Arre-Jay/BlueWavePCB/BOM/Blue_Pedal_BOM.xlsx

Comment | Designator | Footprint | JLCPCB Part # | Description
STM32WB55CGU6 | U1 | UFQFPN-48(7x7) | C404023 | RF Microcontrollers - MCU Ultra-low-power
MIC5205-3.3YM5 | U2 | SOT-23-5 | C37970 | LDO 3V3 Voltage Regulators 150mA 1% Low
LIS2DH12TR | U3 | LGA-12(2x2) | C110926 | Accelerometers MEMS digital output motion sensor
USBLC6-2SC6 | U4 | SOT-23-6 | C7519 | ESD Suppressors / TVS Diodes ESD Protection Low Cap
MHT192CRCT | D1,D2,D3 | 0603 | C389517 | 5mA Colorless transparent lens Red
USB Connector
DLF162500LT-5028A1 | FLT1 | SMD-4P,0.8x1.6mm | C531364 | Low pass 0.33dB SMD-4P,0.8x1.6mm RF Filters
2450AT43B100E | AE1 | - | C2917721 | 1.3dBi Chip Antenna 2.4GHz 2W
NX2012SA-32.768KHZ-EXS00A-MU00644 | X2 | 2012-2P | C2828558 | Crystal 32.768kHz
NX2016SA-32M-EXS00A-CS06465 | X1 | 2016-4P | C1986260 | Crystal 32MHz
7914G-1-000E | SW1, SW2 | - | C840653 | Round Button 100mA
LQG15HS10NJ02D | L1 | 0402 | C77103 | 500mA 10nH ±5% 260mΩ 0402 Inductors (SMD) ROHS
LQM21FN100M70L | L2 | 0805 | C98030 | FIXED IND 10UH 100MA 780MOHM SMD
LQG15HS2N7S02D | L3, L5 | 0402 | C77108 | 800mA 2.7nH 120mΩ 0402 Inductors (SMD)
LQG15HS1N8S02D | L4 | 0402 | C77107 | 1.8nH 0402 Inductors (SMD) ROHS
RC0402FR-075K11L | R1,R2,R3,R4,R5 | 0402 | C274895 | 62.5mW Thick Film Resistors 50V ±100ppm/℃ ±1% 5.11kΩ 0402 Chip Resisto
RC0402FR-131KL | R6,R7,R8,R11,R12,R14 | 0402 | C4247997 | 62.5mW Thick Film Resistors ±100ppm/℃ ±1% 1kΩ 0402 Chip Resistor
RC0402FR-0710KL | R9,R10,R13 | 0402 | C60490 | 62.5mW Thick Film Resistors 50V ±100ppm/℃ ±1% 10kΩ 0402 Chip Resistor
C1608X5R1V475KT000E | C1,C9,C13,C14,C17,C24 | 0603 | C329940 | 35V 4.7uF X5R ±10% 0603 MLCC
C1005X7R1E104KT000F | C2,C3,C4,C5,C7,C8,C10,C18,C21,C22,C23,C25,C26,C27 | 0402 | C189396 | 25V 100nF X7R ±10% 0402 Multilayer Ceramic Capacitors MLCC
CC0402KRX7R9BB101 | C6 | 0402 | C281751 | 50V 100pF X7R ±10% 0402 MLCC
CC0402JRNPO9BN150 | C15, C16 | 0402 | C106997 | 50V 15pF NP0 ±5% 0402 Multilayer Ceramic Capacitors MLCC
GJM1555C1HR80BB01D | C19 | 0402 | C76915 | 50V 0.8pF 0402 Multilayer Ceramic Capacitors MLCC
CQ0402ARNPO9BNR30 | C20 | 0402 | C1870422 | 50V 0.3pF 0402 Multilayer Ceramic Capacitors MLCC
