Arre-Jay/BlueWavePCB/Manufacturing Files/Assembly/Assembly Drawing - Bluetooth board.pdf

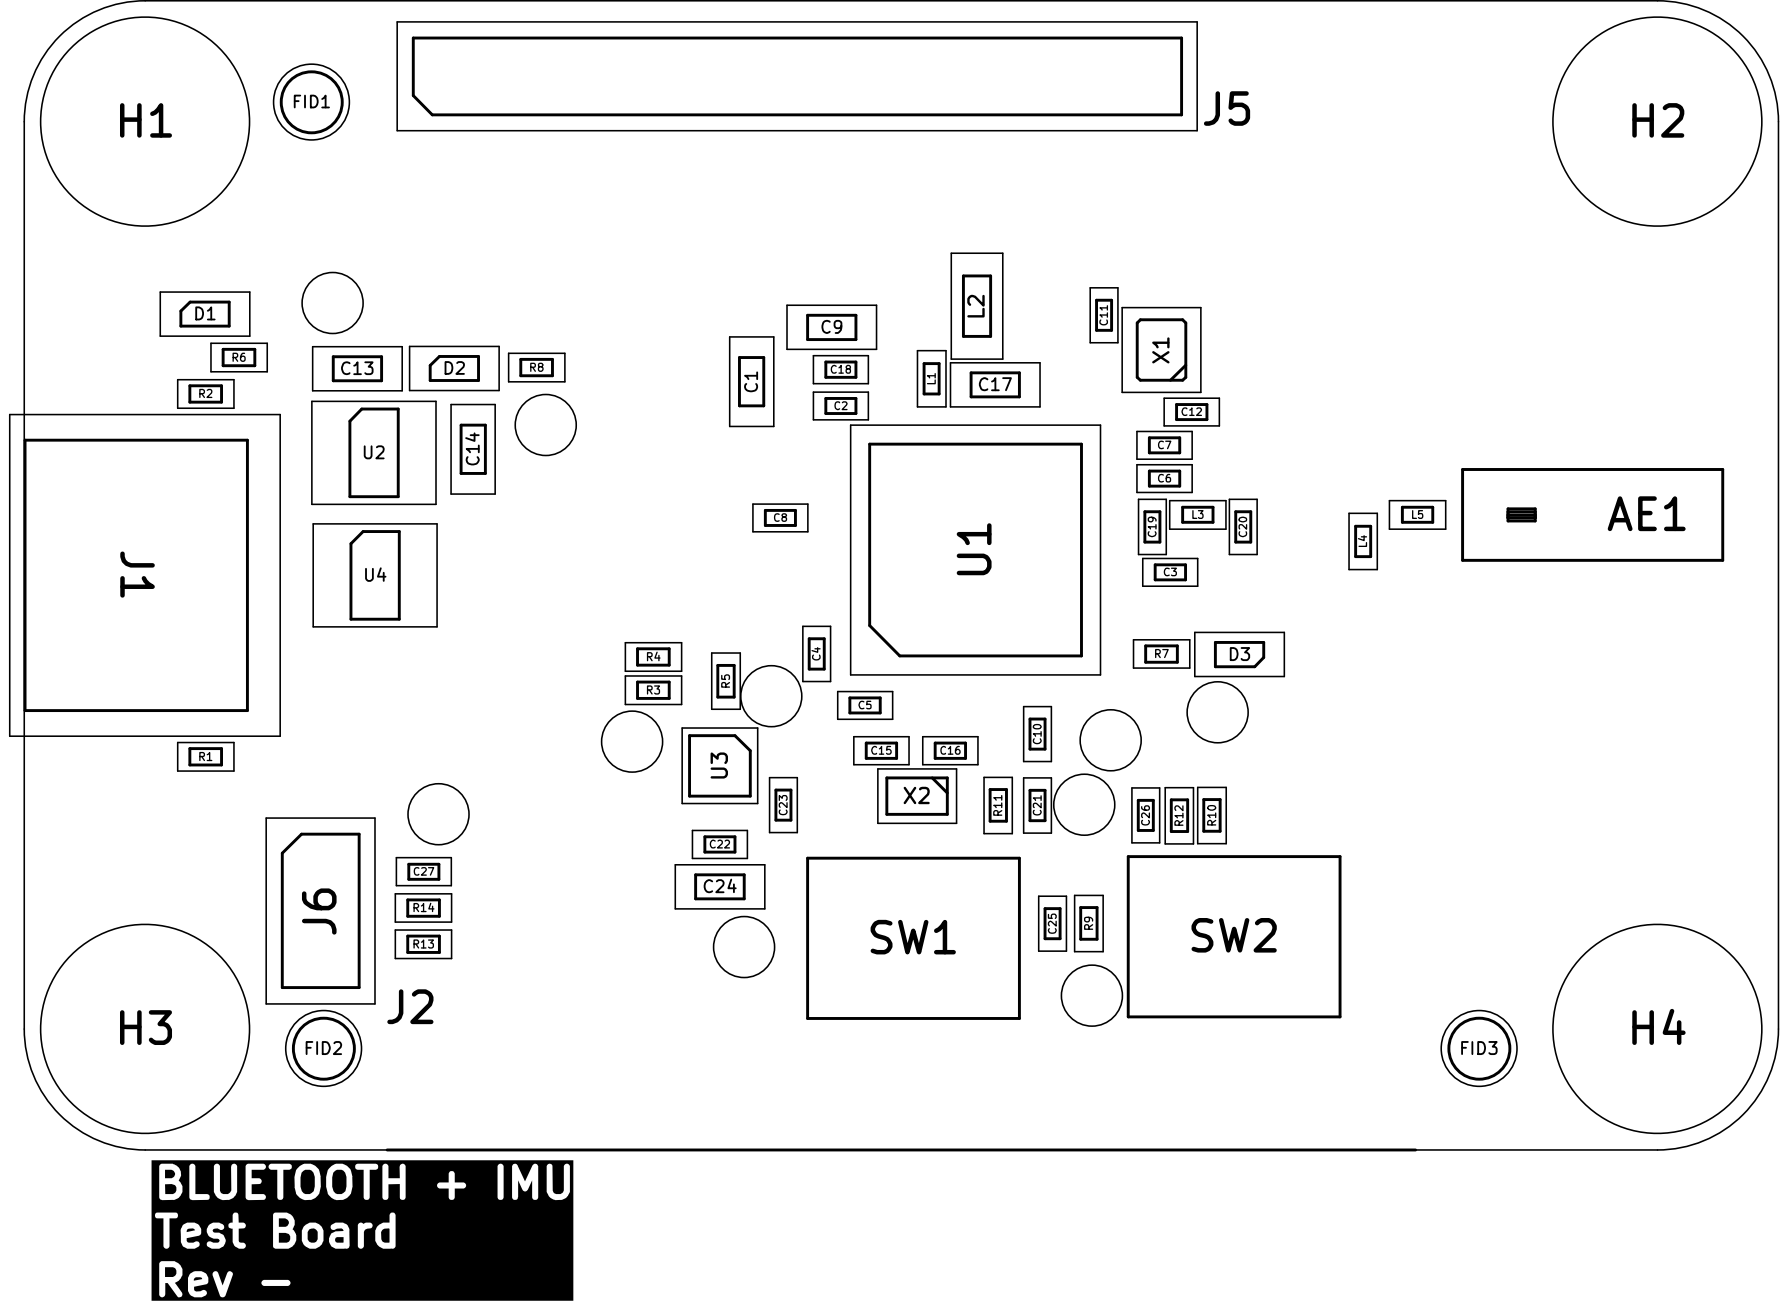
[picture p1: page 1]
