Arre-Jay/BlueWavePCB/Blue_Pedal.kicad_pcb

## KiCad design Blue_Pedal.kicad_pcb (2024-07-24)

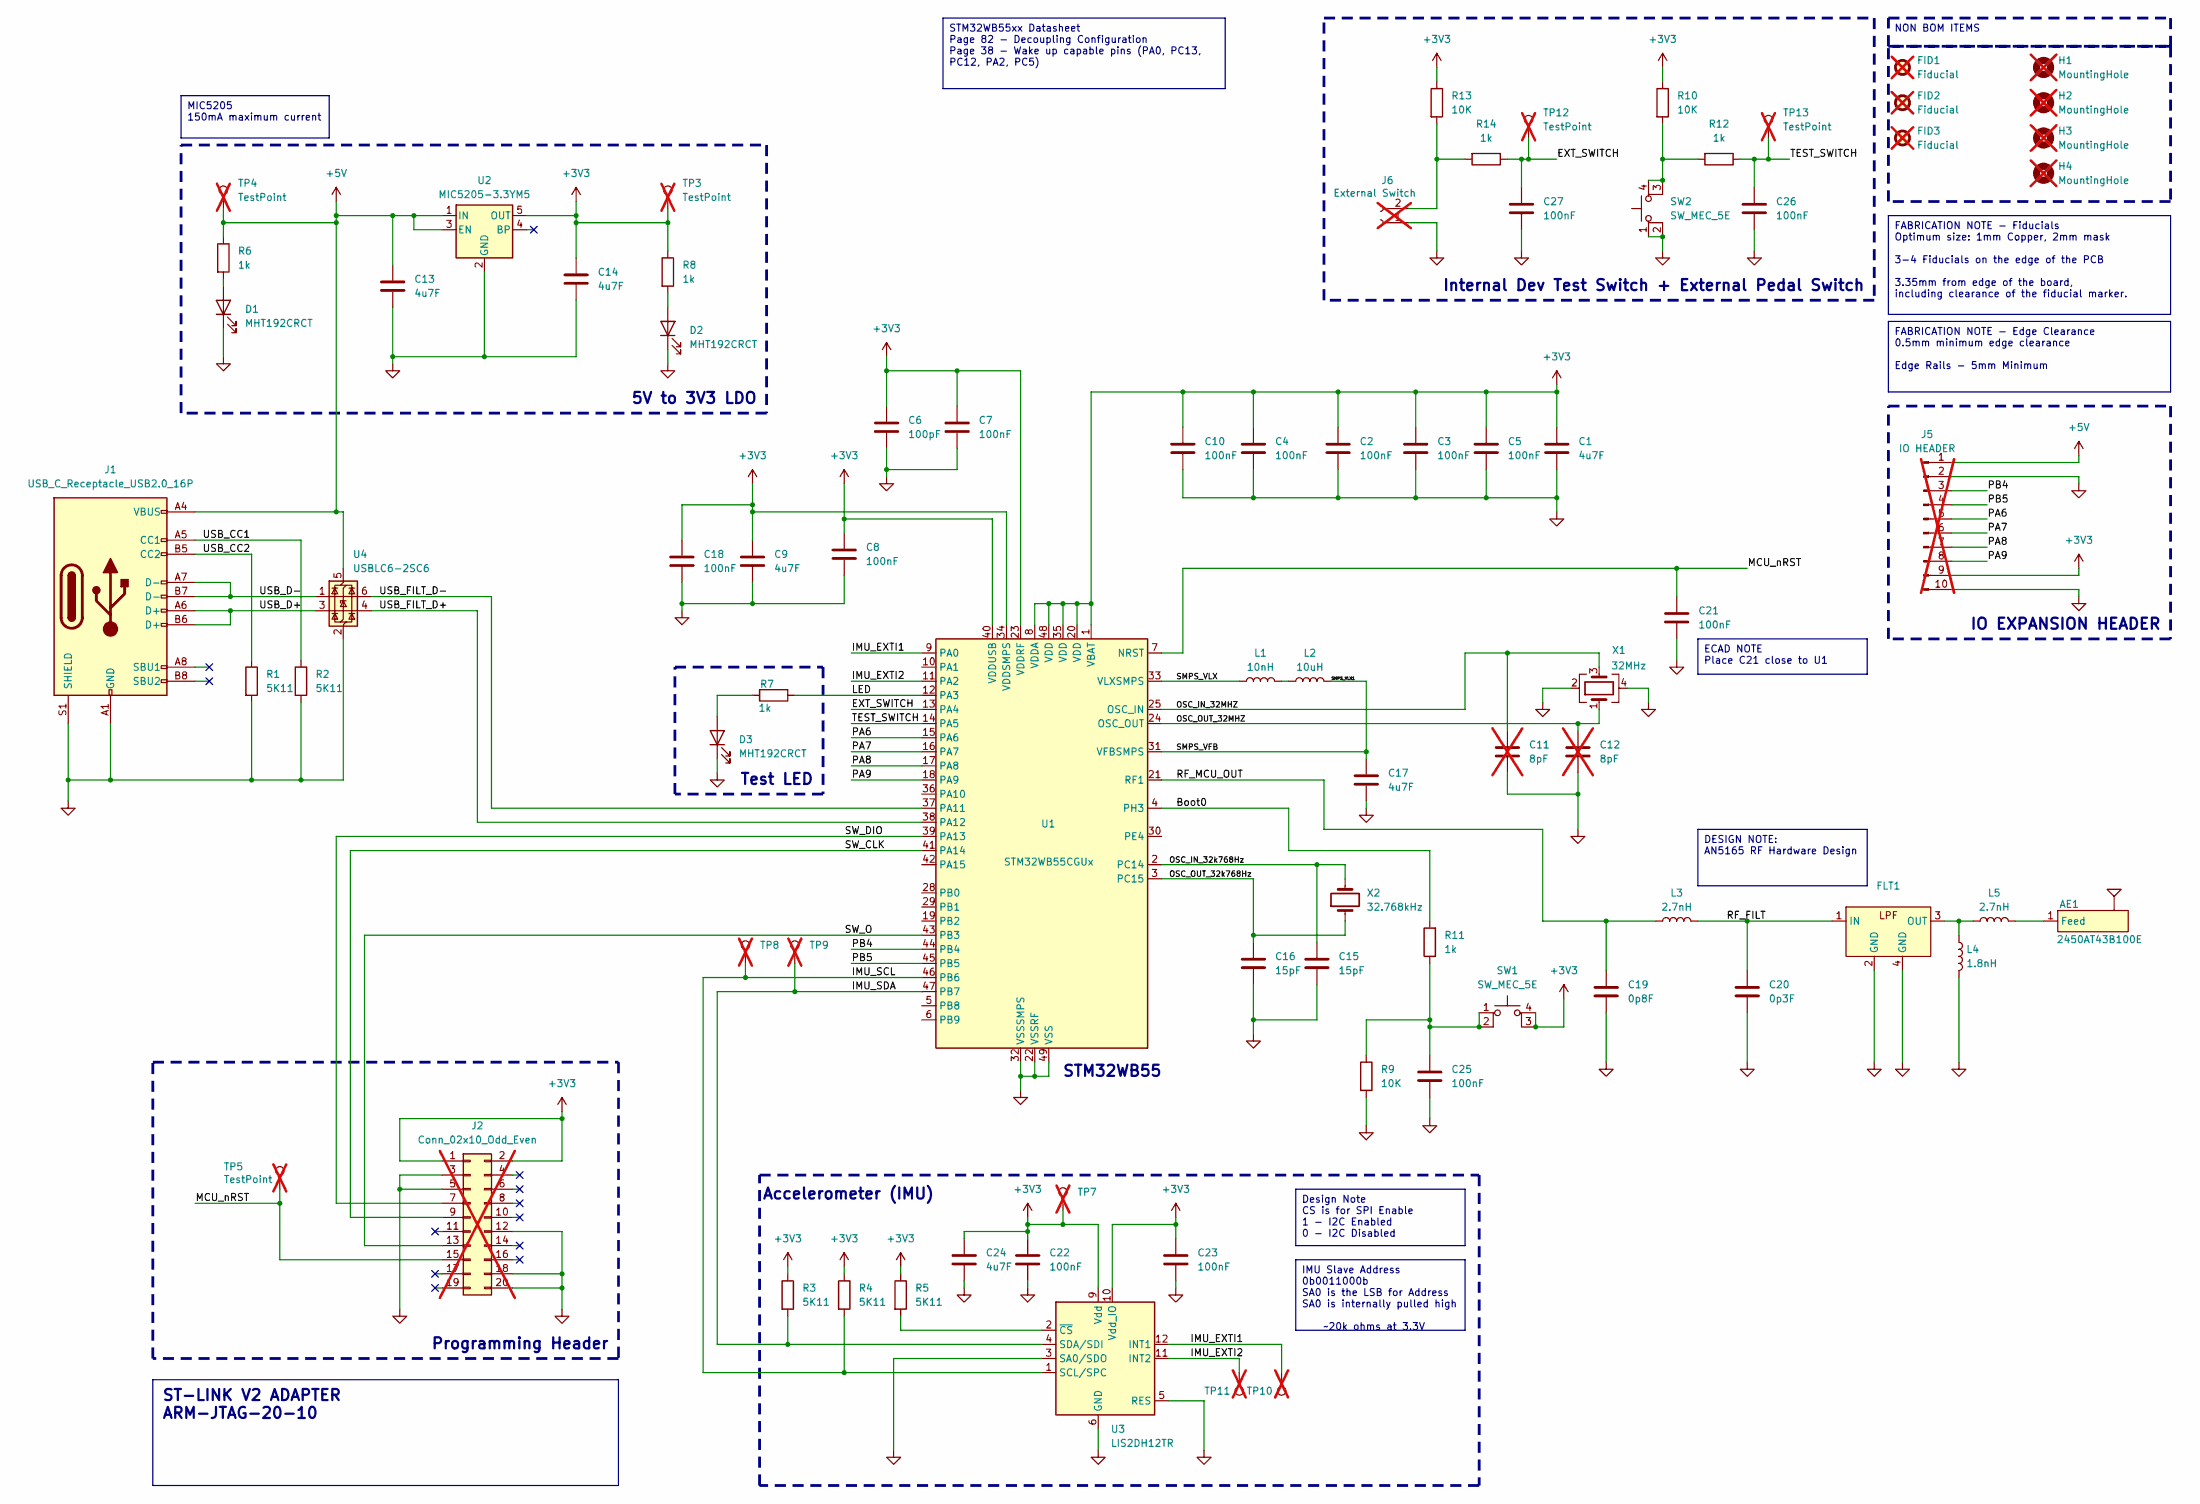
[picture p2: schematic Blue_Pedal.kicad_sch, Blue Pedal]

Parts:
AE1: 2450AT43B100E
C1, C9, C13, C14, C17, C24: 4u7F; C_0603_1608Metric; Manufacturer Part Number C1608X5R1V475KT000E; JLCPCB Part # C329940
C2, C3, C4, C5, C7, C8, C10, C18, C21, C22, C23, C25, C26, C27: 100nF; C_0402_1005Metric; Manufacturer Part Number C1005X7R1E104KT000F; JLCPCB Part # C189396
C6: 100pF; C_0402_1005Metric; Manufacturer Part Number CC0402KRX7R9BB101; JLCPCB Part # C281751
C11, C12: 8pF; C_0402_1005Metric; Manufacturer Part Number CGA2B2C0G1H080DT0Y0F; JLCPCB Part # C342939; not fitted
C15, C16: 15pF; C_0402_1005Metric; Manufacturer Part Number CC0402JRNPO9BN150; JLCPCB Part # C106997
C19: 0p8F; C_0402_1005Metric; Manufacturer Part Number GRM1555C1HR80BA01D; JLCPCB Part # C76988
C20: 0p3F; C_0402_1005Metric; Manufacturer Part Number GRM1555C1HR30BA01D; JLCPCB Part # C88939
D1, D2, D3: MHT192CRCT; LED_0603_1608Metric; Manufacturer Part Number MHT192CRCT; JLCPCB Part # C389517
FID1, FID2, FID3: Fiducial; Fiducial_1mm_Mask2mm; not fitted
FLT1: DLF162500LT-5028A1; Manufacturer Part Number DLF162500LT-5028A1; JLCPCB Part # C531364
H1, H2, H3, H4: MountingHole; MountingHole_3.2mm_M3; not fitted
J1: USB_C_Receptacle_USB2.0_16P; USB_C_Receptacle_GCT_USB4105-xx-A_16P_TopMnt_Horizontal; Manufacturer Part Number GT-USB-7047C; JLCPCB Part # C963218
J2: Conn_02x10_Odd_Even; EDGE_HEADER_20_WAY; not fitted
J5: IO HEADER; PinHeader_1x10_P2.54mm_Vertical; not fitted
J6: External Switch; PinHeader_1x02_P2.54mm_Vertical; not fitted
L1: 10nH; L_0402_1005Metric; Manufacturer Part Number LQG15WZ10NJ02D; JLCPCB Part # C3911026
L2: 10uH; L_0805_2012Metric; Manufacturer Part Number LQM21FN100M70L; JLCPCB Part # C98030
L3: 2.7nH; L_0402_1005Metric; Manufacturer Part Number LQG15HS2N7S02D; JLCPCB Part # C77108
L4: 1.8nH; L_0402_1005Metric
L5: 2.7nH; L_0402_1005Metric
R1, R2, R3, R4, R5: 5K11; R_0402_1005Metric; Manufacturer Part Number RC0402FR-075K11L; JLCPCB Part # C274895
R6, R7, R8, R11, R12, R14: 1k; R_0402_1005Metric; Manufacturer Part Number RC0402FR-131KL; JLCPCB Part # C4247997
R9, R10, R13: 10K; R_0402_1005Metric; Manufacturer Part Number RC0402FR-0710KL; JLCPCB Part # C60490
SW1, SW2: SW_MEC_5E; SMG-H9; Manufacturer Part Number SMG-H9; JLCPCB Part # C7435491
TP3, TP4, TP5, TP7, TP8, TP9, TP10, TP11, TP12, TP13: TestPoint; TestPoint_Pad_D1.0mm; Manufacturer Part Number NA; JLCPCB Part # NA; not fitted
U1: STM32WB55CGUx; QFN-48-1EP_7x7mm_P0.5mm_EP5.6x5.6mm; Manufacturer Part Number STM32WB55CGU6; JLCPCB Part # C404023
U2: MIC5205-3.3YM5; SOT-23-5; Manufacturer Part Number MIC5205-3.3YM5; JLCPCB Part # C37970
U3: LIS2DH12TR; LGA-12_2x2mm_P0.5mm; Manufacturer Part Number LIS2DH12TR; JLCPCB Part # C110926
U4: USBLC6-2SC6; SOT-23-6; Manufacturer Part Number USBLC6-2SC6; JLCPCB Part # C7519
X1: 32MHz; Crystal_SMD_2016-4Pin_2.0x1.6mm; Manufacturer Part Number NX2016SA-32M-EXS00A-CS06465; JLCPCB Part # C1986260
X2: 32.768kHz; Crystal_SMD_2012-2Pin_2.0x1.2mm; Manufacturer Part Number NX2012SA-32.768KHZ-EXS00A-MU00644; JLCPCB Part # C2828558

Connections:
+3V3: C1.1, C2.1, C3.1, C4.1, C5.1, C6.1, C7.1, C8.1, C9.1, C10.1, C14.1, C18.1, C22.1, C23.1, C24.1, J2.1, J2.2, J5.9, R3.1, R4.1, R5.1, R8.1, R10.1, R13.1, SW1.3 (K), SW1.4 (A), TP3.1, TP7.1, U1.1 (VBAT), U1.8 (VDDA), U1.20 (VDD), U1.23 (VDDRF), U1.34 (VDDSMPS), U1.35 (VDD), U1.40 (VDDUSB), U1.48 (VDD), U2.5 (OUT), U3.9 (Vdd), U3.10 (Vdd_IO)
+5V: C13.1, J1.A4 (VBUS), J1.A9 (VBUS), J1.B4 (VBUS), J1.B9 (VBUS), J5.1, R6.1, TP4.1, U2.1 (IN), U2.3 (EN), U4.5 (VBUS)
/Boot0: R11.2, U1.4 (PH3)
/EXT_SWITCH: C27.1, R14.1, TP12.1, U1.13 (PA4)
/IMU_EXTI1: TP10.1, U1.9 (PA0), U3.12 (INT1)
/IMU_EXTI2: TP11.1, U1.11 (PA2), U3.11 (INT2)
/IMU_SCL: R4.2, TP8.1, U1.46 (PB6), U3.1 (SCL/SPC)
/IMU_SDA: R3.2, TP9.1, U1.47 (PB7), U3.4 (SDA/SDI)
/LED: R7.1, U1.12 (PA3)
/MCU_nRST: C21.1, J2.15, TP5.1, U1.7 (NRST)
/OSC_IN_32MHZ: C11.1, U1.25 (OSC_IN), X1.3
/OSC_IN_32k768Hz: C15.1, U1.2 (PC14), X2.2
/OSC_OUT_32MHZ: C12.1, U1.24 (OSC_OUT), X1.1
/OSC_OUT_32k768Hz: C16.1, U1.3 (PC15), X2.1
/PA6: J5.5, U1.15 (PA6)
/PA7: J5.6, U1.16 (PA7)
/PA8: J5.7, U1.17 (PA8)
/PA9: J5.8, U1.18 (PA9)
/PB4: J5.3, U1.44 (PB4)
/PB5: J5.4, U1.45 (PB5)
/RF_FILT: C20.1, FLT1.1 (IN), L3.2
/RF_MCU_OUT: C19.1, L3.1, U1.21 (RF1)
/SMPS_VFB: C17.1, L2.2, U1.31 (VFBSMPS)
/SMPS_VLX: L1.1, U1.33 (VLXSMPS)
/SW_CLK: J2.9, U1.41 (PA14)
/SW_DIO: J2.7, U1.39 (PA13)
/SW_O: J2.13, U1.43 (PB3)
/TEST_SWITCH: C26.1, R12.1, TP13.1, U1.14 (PA5)
/USB_CC1: J1.A5 (CC1), R2.1
/USB_CC2: J1.B5 (CC2), R1.1
/USB_D+: J1.A6 (D+), J1.B6 (D+), U4.3 (I/O2)
/USB_D-: J1.A7 (D-), J1.B7 (D-), U4.1 (I/O1)
/USB_FILT_D+: U1.38 (PA12), U4.4 (I/O2)
/USB_FILT_D-: U1.37 (PA11), U4.6 (I/O1)
GND: C1.2, C2.2, C3.2, C4.2, C5.2, C6.2, C7.2, C8.2, C9.2, C10.2, C11.2, C12.2, C13.2, C14.2, C15.2, C16.2, C17.2, C18.2, C19.2, C20.2, C21.2, C22.2, C23.2, C24.2, C25.2, C26.2, C27.2, D1.1 (K), D2.1 (K), D3.1 (K), FLT1.2 (GND), FLT1.4 (GND), J1.A1 (GND), J1.A12 (GND), J1.B1 (GND), J1.B12 (GND), J1.S1 (SHIELD), J2.3, J2.5, J2.12, J2.18, J2.20, J5.2, J5.10, J6.1, L4.2, R1.2, R2.2, R9.2, SW2.1, SW2.2, U1.22 (VSSRF), U1.32 (VSSSMPS), U1.49 (VSS), U2.2 (GND), U3.3 (SA0/SDO), U3.5 (RES), U3.6 (GND), U3.7 (GND), U3.8 (GND), U4.2 (GND), X1.2, X1.4
unnamed: AE1.1 (Feed), L5.2
unnamed: C25.1, R9.1, R11.1, SW1.1, SW1.2
unnamed: D1.2 (A), R6.2
unnamed: D2.2 (A), R8.2
unnamed: D3.2 (A), R7.2
unnamed: FLT1.3 (OUT), L4.1, L5.1
unnamed: J6.2, R13.2, R14.2
unnamed: L1.2, L2.1
unnamed: R10.2, R12.2, SW2.3 (K), SW2.4 (A)
unnamed: R5.2, U3.2 (~CS)

Notes on the sheet:
Internal Dev Test Switch + External Pedal Switch
IMU Slave Address 0b0011000b SA0 is the LSB for Address SA0 is internally pulled high ~20k ohms at 3.3V
DESIGN NOTE: AN5165 RF Hardware Design
Test LED
ST-LINK V2 ADAPTER ARM-JTAG-20-10
MIC5205 150mA maximum current
STM32WB55xx Datasheet Page 82 - Decoupling Configuration Page 38 - Wake up capable pins (PA0, PC13, PC12, PA2, PC5)
5V to 3V3 LDO
NON BOM ITEMS
ECAD NOTE Place C21 close to U1
FABRICATION NOTE - Fiducials Optimum size: 1mm Copper, 2mm mask 3-4 Fiducials on the edge of the PCB 3.35mm from edge of the board, including clearance of the fiducial marker.
IO EXPANSION HEADER
Programming Header
Design Note CS is for SPI Enable 1 - I2C Enabled 0 - I2C Disabled
FABRICATION NOTE - Edge Clearance 0.5mm minimum edge clearance Edge Rails - 5mm Minimum
Accelerometer (IMU)
STM32WB55

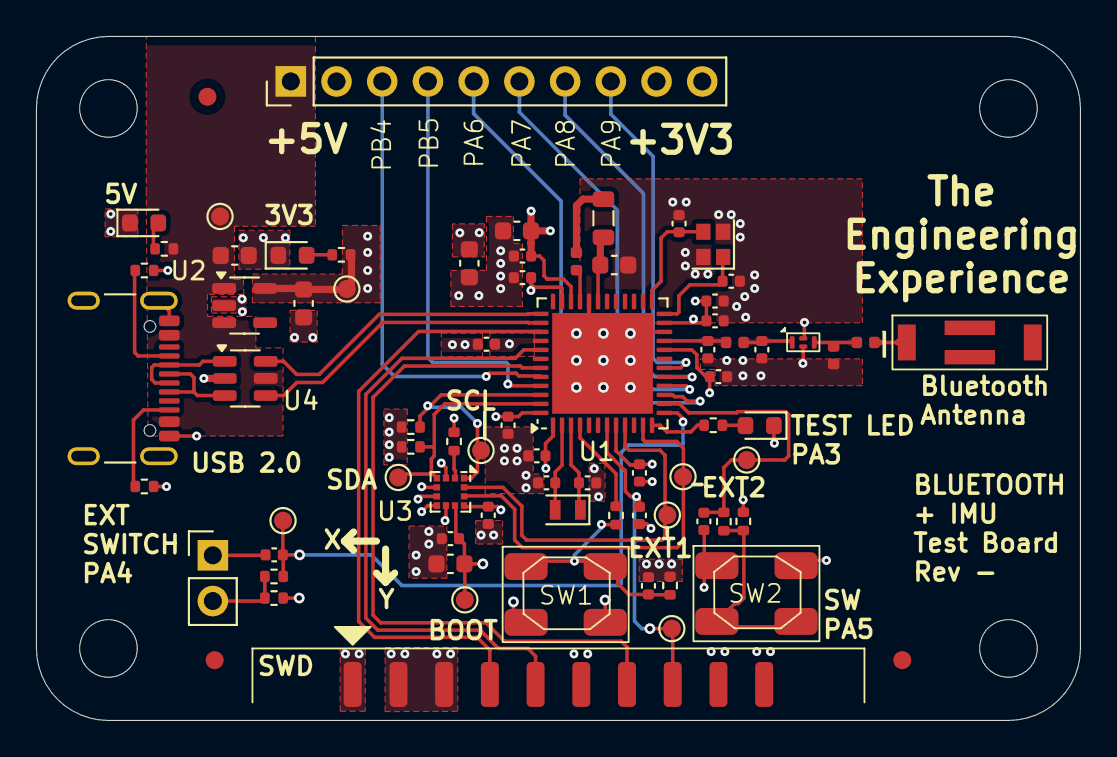
[picture p3: board Blue_Pedal.kicad_pcb from above]

Board: 4 copper layers, 58.0 x 38.0 mm, 80 parts (0 on the bottom side), 45 nets.
